jscastonguay/Programmable-Battery-Power-Saving-Board/README.md

# Programmable-Battery-Power-Saving-Board
Board to save battery life using a RTC to disconnect the battery power from the load.
