jscastonguay/Programmable-Battery-Power-Saving-Board/hw/PCB Programmable battery power saving board.kicad_pcb

## KiCad design hw/PCB Programmable battery power saving board.kicad_pcb (2017-05-10)

Schematic: Programmable battery power saving board.sch

Parts:
BT1: Battery; batter3V
C1, C2, C3: 1u; CP_Radial_D5.0mm_P2.00mm
P1: 277-9143; TerminalBlock_Pheonix_PT-3.5mm_9pol
P2: power_in; AK300-2
P3: power_out; AK300-2
Q1, Q2, Q3, Q5: TN0606N3-G; TO-92_Inline_Narrow_Oval
Q4: IPP45P03P4L-11; TO-220_Vertical
Q6: LP0701N3-G; TO-92_Inline_Narrow_Oval
R1, R2, R3, R4: 470k; R_Axial_DIN0207_L6.3mm_D2.5mm_P7.62mm_Horizontal
R5, R9, R10: 10k; R_Axial_DIN0207_L6.3mm_D2.5mm_P7.62mm_Horizontal
R6, R7: 330k; R_Axial_DIN0207_L6.3mm_D2.5mm_P7.62mm_Horizontal
R8: 30k; R_Axial_DIN0207_L6.3mm_D2.5mm_P7.62mm_Horizontal
SW1, SW2: SW_PUSH; sw_push
U11: DS3231S; SOIC-16W_7.5x10.3mm_Pitch1.27mm

Connections:
GND: BT1.2, C1.2, C2.1, C3.2, P1.8, P2.2, P3.2, Q1.1 (S), Q2.1 (S), Q3.1 (S), Q5.1 (S), R3.2, R6.2, R9.2, SW2.2, U11.5 (N.C.), U11.6 (N.C.), U11.7 (N.C.), U11.8 (N.C.), U11.9 (N.C.), U11.10 (N.C.), U11.11 (N.C.), U11.12 (N.C.), U11.13 (GND)
unnamed: BT1.1, C1.1, R4.1, U11.14 (VBAT)
unnamed: C2.2, U11.2 (Vcc)
unnamed: C3.1, P1.5, R8.2, R9.1
unnamed: P1.2, U11.16 (SCL)
unnamed: P1.3, U11.15 (SDA)
unnamed: P1.4, U11.4 (RST)
unnamed: P1.6, Q5.2 (G), R6.1
unnamed: P1.7, Q3.2 (G), R3.1
unnamed: P1.9, R10.2, SW2.1
unnamed: P2.1, Q4.3 (D), Q6.3 (D), R1.1, R2.1, R7.1, SW1.1
unnamed: P3.1, Q4.2 (S), SW1.2
unnamed: Q1.2 (G), R4.2, U11.3 (INT/SQW)
unnamed: Q1.3 (D), Q2.2 (G), R1.2
unnamed: Q2.3 (D), Q3.3 (D), Q4.1 (G), R2.2
unnamed: Q5.3 (D), Q6.2 (G), R7.2
unnamed: Q6.1 (S), R8.1
unnamed: R5.2, U11.1 (32kHz)
VCC: P1.1, R5.1, R10.1

Notes on the sheet:
Pinout P1 (1) Vcc from the controler (3.3V, 5V) (2) SCL from the controler (3) SDA from the controler (4) RST from the controler (5) Valim - voltage divisor per 4 (6) Measure Valim? from an external source (7) Power controler (8) GND from the controler (9) maintenance
Alimentation from the external power source
RTC (real-time clock) module
Voltage divisor for the measure of Valim
Mode selection: normal or maintenance

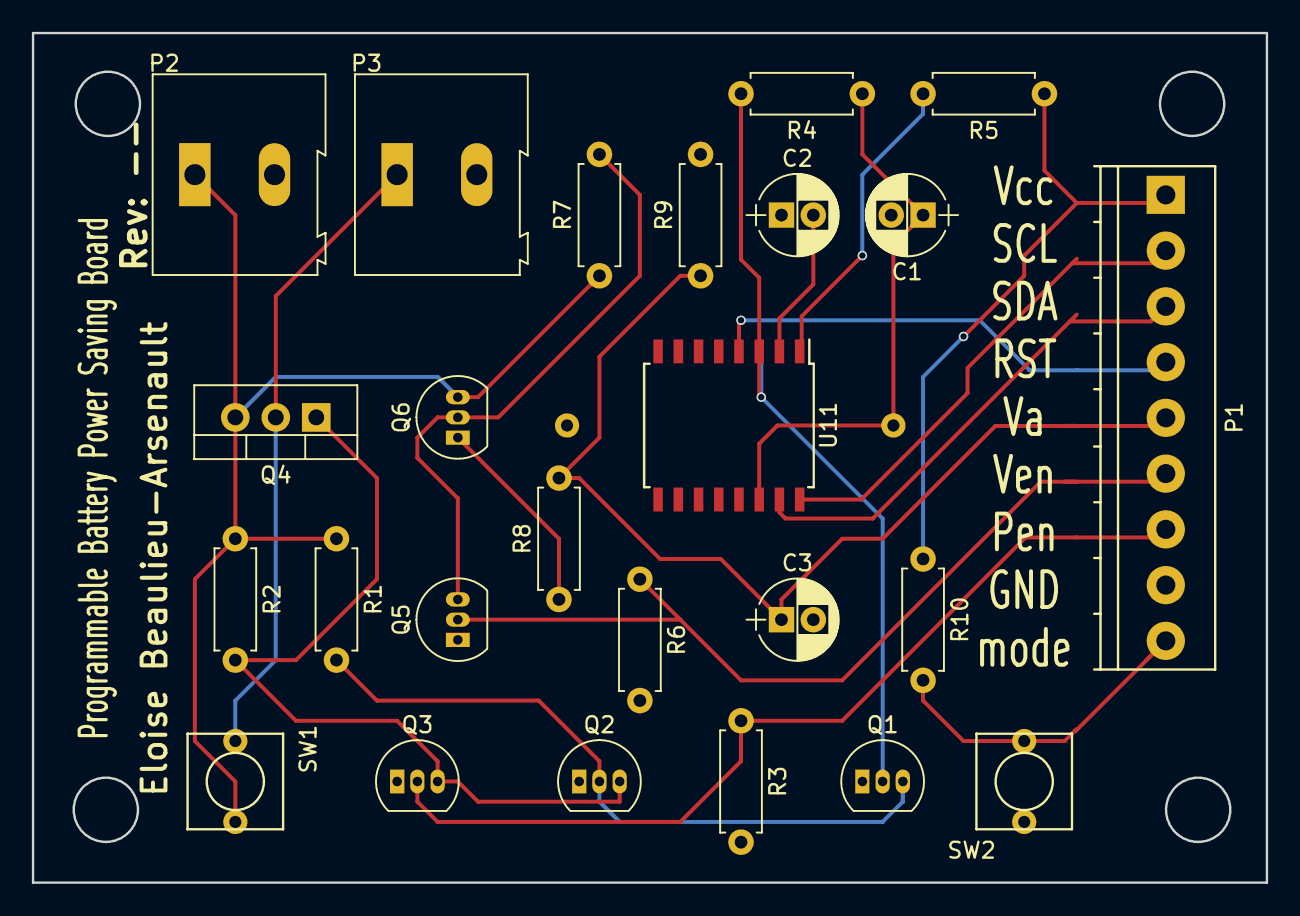
[picture p1: board PCB Programmable battery power saving board.kicad_pcb from above]

Board: 2 copper layers, 77.5 x 53.3 mm, 26 parts (1 on the bottom side), 19 nets.
