jscastonguay/Programmable-Battery-Power-Saving-Board/(threads)

Thread 1 (2017-05-10):

Le circuit d'activation de la lecture VALIM ne fonctionne pas

jscastonguay, 2017-05-10:
Lorsque "disable", le circuit tire beaucoup de courant. Ce pourrait être Q6 qui est à l'envers.

jscastonguay, 2017-05-19:
Source du problème: Q6 est à l'envers. Interchanger pins 1 et 3.
