jscastonguay/Programmable-Battery-Power-Saving-Board/(commit log)

2017-05-10 During dev.
    [PCB Programmable battery power saving board.kicad_pcb, Programmable battery power saving board.sch]
2017-05-14 Last changed from Eloise
    [Programmable battery power saving board.sch]
