jscastonguay/Programmable-Battery-Power-Saving-Board/(notices)

Notices in the files:
hw/PCB Programmable battery power saving board.kicad_pcb:
Copyright 2017 Eloïse Beaulieu-Arsenault
hw/Programmable battery power saving board.sch:
Copyright 2017 Éloïse Beaulieu-Arsenault
